ardyesp/PowerMeter/docs/MeterInUse.png

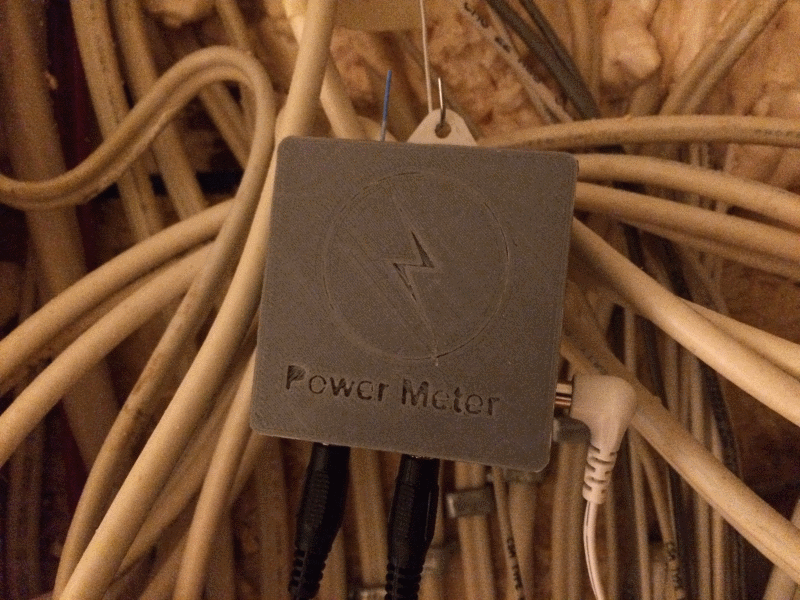
docs/MeterInUse.png
