ardyesp/PowerMeter/(commit log)

2017-01-16 Added schematic diagram
2017-03-10 Added smartwatch based power display, modified code to use new Arduino repo
2019-03-31 Added Watchdog timer reset
    [PowerMeter.ino, Reader.ino]
2024-01-04 Fix the ground wire in schematic diagram
